umarf2212/motion-bench/pcb-design/gyro-carrier.kicad_pcb

## KiCad design pcb-design/gyro-carrier.kicad_pcb (2026-11-12)

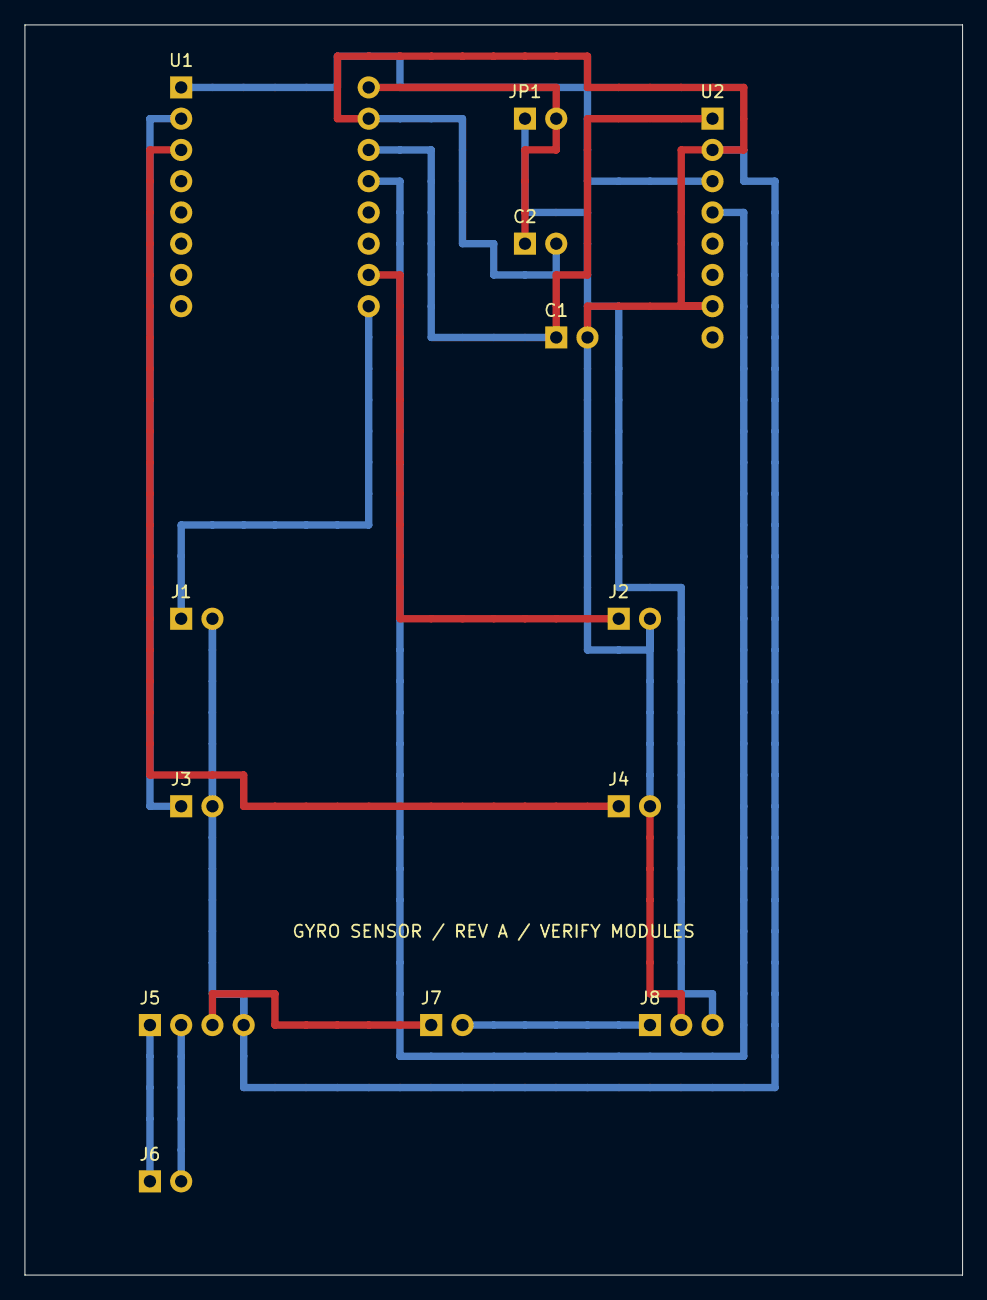
[picture p1: board gyro-carrier.kicad_pcb from above]

Board: 2 copper layers, 76.2 x 101.6 mm, 13 parts (0 on the bottom side), 14 nets.

Parts:
C1: 100 nF ceramic; C1
C2: 100 µF / 10 V; C2
J1: Left click; J1
J2: Right click; J2
J3: Hold to move; J3
J4: Hold to scroll; J4
J5: Charger interface; J5
J6: Battery connector; J6
J7: Power switch; J7
J8: 5 V regulator interface; J8
JP1: Battery isolation link; JP1
U1: ESP32-C3 SuperMini; U1
U2: MPU-6050 / GY-521; U2

Connections:
BAT_MINUS: J5.2, J6.2
BAT_PLUS: J5.1, J6.1
BOOST_5V: J8.3, JP1.1
GND: C1.2, C2.2, J1.2, J2.2, J3.2, J4.2, J5.4, J8.2, U1.10, U2.2, U2.7
LEFT: J1.1, U1.16
MOVE: J3.1, U1.2
PROTECTED_PLUS: J5.3, J7.1
RIGHT: J2.1, U1.15
SCL: U1.1, U2.3
SCROLL: J4.1, U1.3
SDA: U1.12, U2.4
SWITCHED_BAT: J7.2, J8.1
V3V3: C1.1, U1.11, U2.1
V5: C2.1, JP1.2, U1.9
